MHeiIT/ESP-SmartMeter-Reader/PDFs/SmartMeter_KS_Schematics_without_BuckConverter.pdf

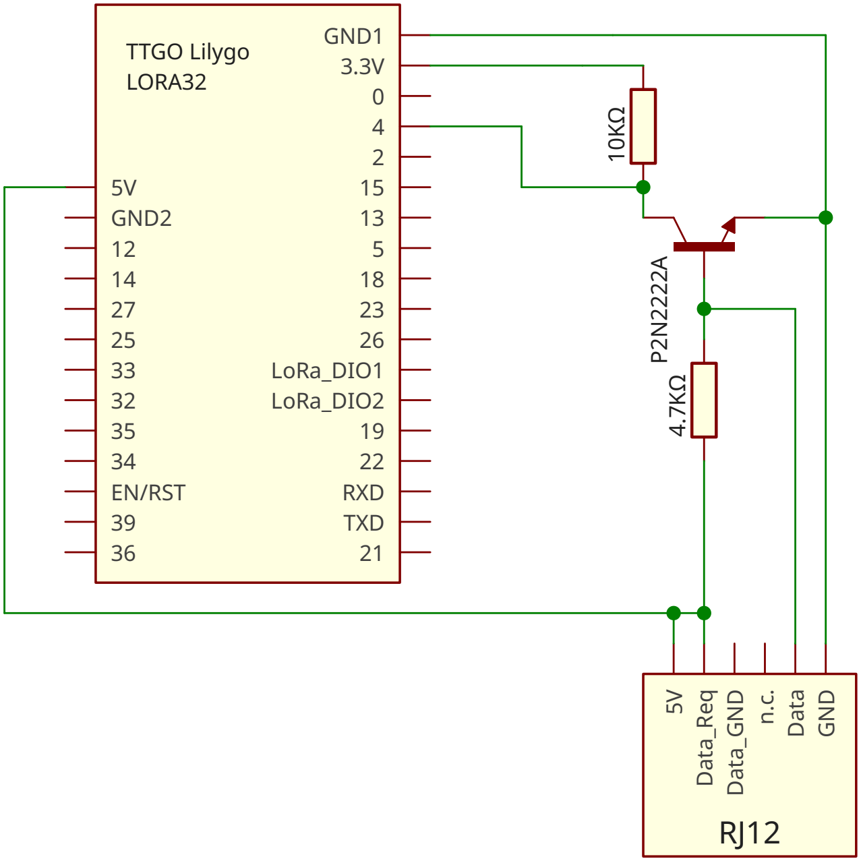
[picture p3: figure]
GND; Data_Req; Data_GND; Data; GND2; LoRa_DIO1; EN/RST; RXD; TXD; GND1 3.3V2; LoRa_DIO2; TTGO Lilygo; LORA32
