MHeiIT/ESP-SmartMeter-Reader/PDFs/SmartMeter_KS_Schematics.pdf

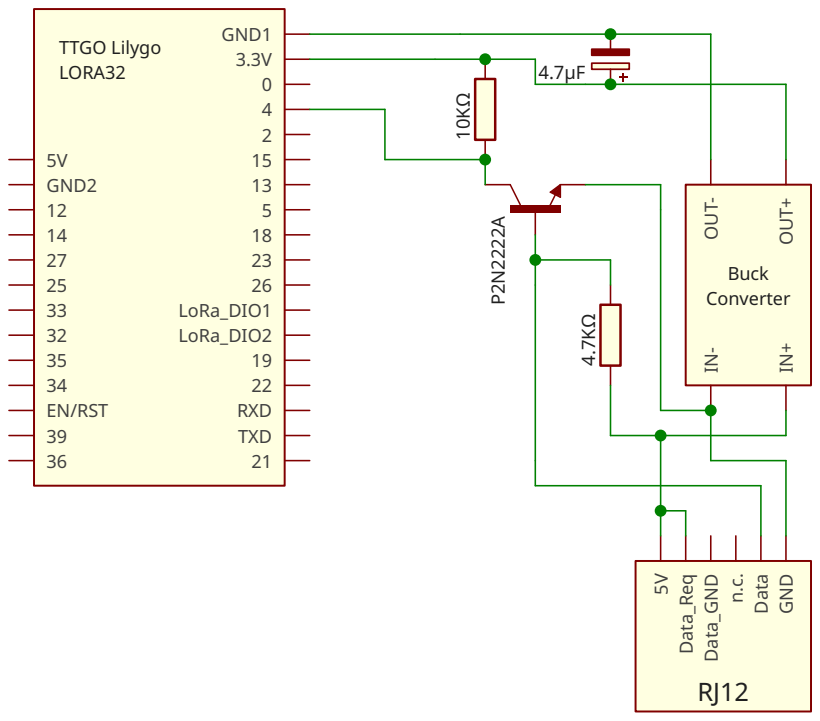
[picture p4: page 1]

IN+ OUT- OUT+
